feng147369/high-speed-intelligent-particle-pulse-discrimination-system/board/photos/platform.png

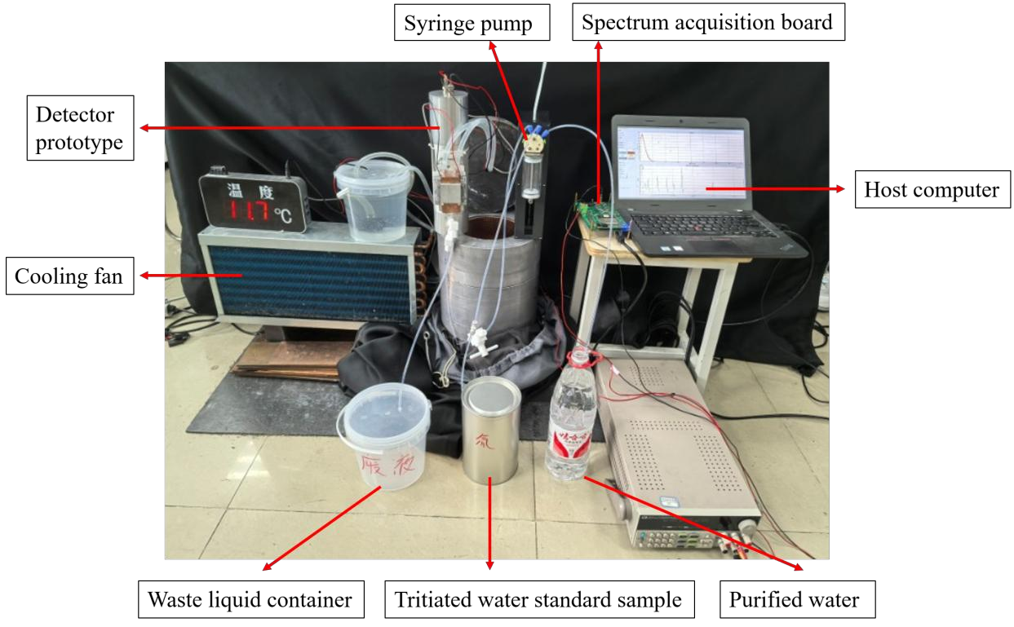
board/photos/platform.png
