feng147369/high-speed-intelligent-particle-pulse-discrimination-system/board/photos/enclosure.png

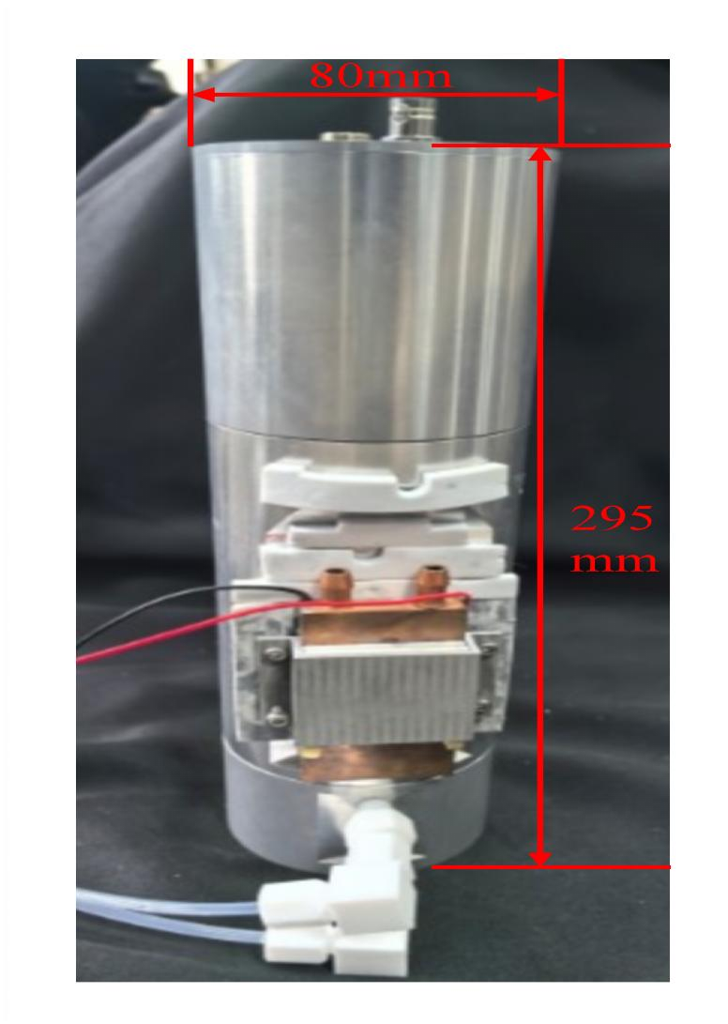
board/photos/enclosure.png
