feng147369/high-speed-intelligent-particle-pulse-discrimination-system/README.md

# 基于 FPGA 与轻量神经网络的高速氚水在线测量系统

全国大学生嵌入式芯片与系统设计竞赛 2026 · FPGA 自主选题赛道 · 高级组

## 项目简介

本项目面向核设施及环境水体中氚的在线监测需求，研制了一套集高速采集、实时波形处理、轻量神经网络甄别和网络测量分析于一体的氚水在线测量系统。

系统采用 CaF₂(Eu) 晶体探测器和光电倍增管完成信号探测与光电转换，使用 AD9694 四通道 14 位 500 MSPS ADC、LMK04828 时钟器件和 XC7K325T FPGA 构成高速数字化电子学。FPGA 通过 JESD204B 接收数据，以 250 MHz 双样点并行流水结构完成动态基线估计、触发、峰值、总积分、尾积分、脉宽和过阈样点统计。

系统部署定点轻量一维 CNN，通过统一事件号和事件缓存，将预筛、特征提取与 CNN 结果关联到同一事件。传统模式按预筛结果放行，AI 模式联合预筛、CNN 得分和原始波形满码检查形成最终判决。

有效事件进入原始波形上传和能谱累积路径，经 SiTCP 千兆以太网传输至 MATLAB 上位机，实现参数配置、波形与能谱显示、AI 状态回读、原始数据保存和氚水测量分析。系统已完成硬件设计、FPGA 开发、上位机集成、上板运行及氚水实测。

## 主要功能

- 500 MSPS 原始采样与 JESD204B 接收，每周期处理两个连续样点。
- 动态基线、候选触发、过阈样点预筛和波形特征提取。
- 1281 点原始事件缓存，首尾跨度 2.56 μs。
- 五点均值与降采样形成 257 点 CNN 输入。
- 定点 CNN 推理、Q14 得分判决和原始满码否决。
- 同一事件的预筛、特征、波形与 AI 判决关联。
- 波形及累计能谱完整包调度、48 位 FPGA 事件时间戳。
- 暂停排空、配置边界控制及网络背压处理。

## 硬件与工具

| 项目 | 配置 |
|---|---|
| FPGA | XC7K325T-2FFG900 |
| ADC | AD9694，四通道、14 位、500 MSPS |
| 时钟器件 | LMK04828 |
| 当前测量通道 | 板上通道 1，对应 AD9694 D 通道 |
| FPGA 样点处理 | 250 MHz，每周期两个连续样点 |
| 网络 | SiTCP、RGMII、千兆以太网 |
| 整机开发 | Vivado 2022.1 |
| AI 模块生成 | 2026.1 工具环境 |
| 上位机验证环境 | MATLAB R2025b |

## 测量成果

| 指标 | 结果 |
|---|---|
| 本底计数率 | 0.36 cps |
| 标准氚水样品计数率 | 160.24 cps |
| 净计数率 | 159.88 cps |
| 探测效率 | 约 0.04% |
| 最低可探测活度浓度 | 3255 Bq/L，4 h |
| 连续测量稳定性 | 12 h，计数率 RSD 0.96% |

## FPGA 实现结果

综合运行：`synth_raw_recording_20261103`；实现运行：`impl_raw_recording_20261103`。

| 项目 | 结果 |
|---|---|
| WNS / WHS | +0.069 ns / +0.052 ns |
| LUT / 寄存器 | 40074 / 55472 |
| Block RAM Tile / DSP | 265 / 318 |
| 总线偏斜约束 | 14 项通过，最小余量 +3.195 ns |
| 布线错误 / DRC Error | 0 / 0 |

## 仓库结构

```text
tritium_fpga/
├── README.md
├── src/       公开处理模块、IP 配置与约束
├── sim/       当前模型和上位机验证结果
├── build/     成功运行的文本报告与版本信息
├── board/     整机、板卡与实验平台实物
├── data/      波形、模型与测量参考结果
├── skill/     技能包目录
└── report/    设计报告、框图与协作记录
```

## 资料使用

1. 阅读[公开源码与接口](src/README.md)，查看数据处理、CNN、事件门控和能谱模块。
2. 阅读[验证记录](sim/README.md)与[实现报告](build/README.md)，对照功能及工程结果。
3. 按[运行说明](board/README.md)了解测量连接、参数和上位机操作。
4. 使用[数据与参考结果](data/README.md)查看波形、模型和测量统计。
5. 使用[技能包](skill/README.md)分析 ILA 数据、复用诊断及模型部署流程。
6. 阅读[设计报告](report/README.md)和[大模型协作记录](report/llm_collaboration.md)。

公开文件校验值见 `manifest.json`。
