feng147369/high-speed-intelligent-particle-pulse-discrimination-system/skill/fpga-adc-pulse-ai/references/03-case-evidence.md

# 案例事实链与官方定义

范围限于 AD9694 标识板卡的低位固定与能谱改善过程，不并入其他板卡资料。所有数字来自已保存的分析摘要，原始 CSV 未随包分发，**不能用摘要重建波形**。

## 一、事实链

| 记录 | 验证结果 | 证据限制 |
|---|---|---|
| demo_adc.csv，16384 行 | A 通道 sample0 不同码 138、码间隔 32、低 5 位全 0；B/D 恒为 8160 | 常量 B/D 不能用于判定位数 |
| 内部 Ramp 一次有效采集 | A 的 8192 样点中，8191 个相邻差均模 16384 加 1 | 仅覆盖 A 与该测试注入路径 |
| read2 / read3 回读 | AB/CD ID=DC、mode=00、N=0D、N′=2F；scratch 通过 | 静态结果不能证明实际 SPI 频率；相同哈希不证明重复采集 |
| 用户仅改 0x0200 的 00→08 | 报告低位恢复；ad6684.csv 中 A sample0/1 不同码 2788/2810，C 为 1884/1911，四字段间隔 1、低 5 位取遍全部 32 种组合 | 该文件无 SPI 回读；不能当作 ENOB=14；B/D 仍为 8191 |
| 约 20 分钟能谱反馈 | 主双峰明显改善，仍存小凸起 | 未取得同条件前后完整累计直方图 |
| 1.csv / 2.csv | 前者无新事件；后者一次有效事件：51812−34488=17324，当前映射为 2165 道 | 未捕获 2172 道的稀有事件 |

另有照片与 BOM 标 AD9694，与 ID=DC 矛盾——保留矛盾，不作裁定。

## 二、历史量化数据

- 历史 real_9694.csv：16384 行、交织 32768 样本；A 幅值 344–4693；33 个脉冲峰 4676–4693；低 5 位出现全部 32 种组合。按 500 MSPS 覆盖 65.536 μs，重复周期 2 μs，半高宽估计 0.338 μs。
- v10 与 demo 对照：LMK 128 条配置、JESD/PHY 参数、主要复位序列一致；另存 lane 01/0F、13 条未公开写入差异，但未分别证明为掉同步根因。
- 保留 v10 接口的配置版仿真：48 条 SPI 写入与 demo 匹配、复位等待 ≥ 5 ms、无重复初始化；这不是完整 JESD 上板通过。

## 三、官方定义对照

| 项目 | AD9694 Rev.C | AD6684 Rev.A |
|---|---|---|
| 0x0004 ID | DB，第 74 页 | DC，第 75 页 |
| 0x0200 低 4 位默认 | 00，第 79 页 | 07，第 80 页 |
| 0x0200 = 00 | 全带宽 | 全带宽 |
| 全带宽输出位宽 | 14 位后补 2 个零，第 33 页 | 9 位后补 7 个零，第 32 页（启用 tail bits 时例外） |
| 0x0200 = 08 | 未列为支持模式 | VDR，第 80 页 |
| 0x058F=0D / 0x0590=2F | N14 / N′16、Subclass 1，第 91 页 | 同义，第 94 页 |

来源页码为指定版本页脚页码，换版须重新核对。

**推导**：9 位加 7 个零的 16 位字取 [15:2]，即 9 位加 5 个零，与原现象吻合。N 字段写 14 不能恢复已在内部模式中被置零的信息。模式对照支持"AD6684 功能行为"这一解释，**不等于实物鉴定**。

AD6684 第 51、52、88 页规定 VDR 受频谱 mask 约束、可降位；0x0430 默认 01 为复数模式。独立实数脉冲须核对实数模式与调谐频带：0x0430=00、0x0434=02 是实数 0～fs/4 的**待验证方案**，不是强制全带宽 14 位。

## 四、未闭环项目

- 未提供冷上电默认模式与被动原始 ID 位序的实板验证结果。
- 未记录 VDR 降位状态，不能承诺全条件 14 位有效精度。
- B/D 恒值与第二块板的 JESD 不稳定未计入已解决项。
- 截图主峰 2161 道 17973 计数、总计数 78803、2172 道 2 计数；单道占约 0.00254%，**不是**次峰积分占比。纵轴只到 120，不能据图求 FWHM。
- 稀有凸起未被捕获，不直接归因于 VDR、堆积或基线。
