feng147369/high-speed-intelligent-particle-pulse-discrimination-system/data/README.md

# 测试数据与参考结果

## 目录

- waveforms/：四组完整波形 CSV、提取说明及统计。
- measurements/：氚水测量结果。
- model/：模型参数、规则标签、划分、预测及评估结果。
- figures/：原始波形图。

## 四组完整波形

四组波形采集于 **2026 年 9 月 7 日至 9 月 15 日**。日期记录见 `waveforms/acquisition_dates.json`。

每帧保留 257 个 16 位采样字，共 85925 帧。

| 数据组 | 文件 | 有效帧数 |
|---|---|---:|
| PMT 单独测量 | group_1_waveforms.csv | 16631 |
| 本底 | group_2_waveforms.csv | 5156 |
| 氚水样品 | group_3_waveforms.csv | 62387 |
| 25 ℃遮光本底 | group_6_waveforms.csv | 1751 |

原始提取结果位于 waveforms/，图形展示孤立小脉冲、离散脉冲、密集脉冲簇和高幅度事件。

## 当前模型数据

当前模型使用本底批次 13497 条、氚水批次 12258 条，共 25755 条原始波形。原始事件为 1281 点，2 ns/点，首尾跨度 2.56 μs；模型输入为五点均值和步长 5 处理后的 257 点。

标签按完整窗口中独立连续过阈区段建立：回落后再次过阈计为新区段；至少 4 个区段且原始帧未满码为候选；任一点达到 65532 或以上执行满码拒绝。采集批次分别按时间划分训练、验证和留出数据，集合间设置空档。

## 模型结果

时间留出集 3864 条，规则正类 1161 条、规则负类 2703 条。以下结果按上述波形规则标签计算。

| 判决 | 正类召回率 | 负类误放率 | 通过中符合规则比例 |
|---|---:|---:|---:|
| 原定点模型 | 18.43% | 20.75% | 27.61% |
| 新定点 CNN | 84.15% | 3.33% | 91.57% |
| 新 CNN 与原始满码否决联合 | 84.15% | 0.37% | 98.99% |

模型标识为 20261103，默认 Q14 阈值为 4043。model/ 保存浮点和定点参数、标签划分、量化验证及预测结果。

## 氚水测量

标准样品比活度为 2.230×10⁴ Bq/g，测量体积为 18 mL，PMT 高压为 900 V。

| 参数 | 结果 |
|---|---|
| 本底计数率 | 0.36 cps |
| 样品计数率 | 160.24 cps |
| 净计数率 | 159.88 cps |
| 探测效率 | 约 0.04% |
| 最低可探测活度浓度 | 3255 Bq/L，4 h |
| 连续测量稳定性 | 12 h，RSD 0.96% |

净计数率 `Rn=Rs-Rb`；探测效率 `ε=Rn/(aρV)`。结果表位于 measurements/results.csv。

## 单位

原始样点为 uint16，间隔 2 ns；CNN 输入间隔 10 ns；得分为有符号 Q14；FPGA 时间戳为 48 位、4 ns/刻度；能谱每道计数为 uint32；计数率单位 cps，活度浓度单位 Bq/L。
