feng147369/high-speed-intelligent-particle-pulse-discrimination-system/skill/pitfalls.md

# 高速采集与脉冲 AI 开发经验

## 1. 将“位数异常”转为原始码统计

现象：采样字低位固定，码值呈固定间隔变化。

处理：检查解包后的原始字段，统计低位集合、码值间隔和有效周期，再核对器件模式与接收端切片。

提炼：将转换数据、内部处理格式、传输字和算法输入逐层对应，定位信息在哪一层发生变化。

## 2. 先检查 SPI 读阶段的方向控制

现象：寄存器读回全零或全 FF，重复读取仍保持相同值。

处理：检查 SDIO 在读阶段的释放、顶层 IOBUF 使能、指令位序和采样时刻，并通过暂存器校验和原始串行观察复核。

提炼：回读结果与总线行为一起记录，再使用寄存器值分析器件。

## 3. 区分锁存结果和独立事件

现象：ILA 中相同峰值连续保持多行。

处理：用事件有效信号筛选峰值，并分别统计采样行数、有效周期和事件次数。

提炼：字段更新机制决定统计口径。锁存字段按更新事件统计。

## 4. 从活动工程对照示例与业务差异

现象：同一板卡在示例工程正常，在业务工程出现同步异常。

处理：从实际顶层和活动文件出发，对照时钟、ADC、JESD204B、复位及运行期配置，逐项复验。

提炼：源码注释、历史副本和当前加载配置分别核对，以实际工程数据流作为定位入口。

## 5. 原始点数需要对应物理时间

现象：模型输入同为 257 点，但采样间隔改变后覆盖时间不同。

处理：固定 2.56 μs 观察窗，使用 1281 点原始帧，经五点均值和步长 5 形成 257 点输入。

提炼：窗口长度、点间隔和预处理一起管理，训练与硬件使用相同输入定义。

## 6. 将人工“峰数”判据落实为可执行规则

现象：回摆、小峰和连续过阈区段的不同计法会改变标签。

处理：按已确认的规则，回落后再次过阈计为新区段；完整窗口内至少 4 个区段且未满码为候选。

提炼：将会改变标签的边界用具体波形确认，并保存规则版本。

## 7. 采集来源与事件标签分别保存

现象：同一个样品批次内包含多种波形形态。

处理：来源作为采集元数据，逐事件按统一规则标注。本底与氚水数据使用相同标签定义。

提炼：保留原始来源、采集参数和逐事件标签之间的对应关系。

## 8. 原始满码检查放在均值处理之前

现象：短暂单点满码经过五点均值后幅度降低。

处理：扫描完整 1281 点原始帧，独立保存满码标志，再与 CNN 得分联合判决。

提炼：需要保留的原始域条件在信息变换前计算，模型得分和组合判决原因分别记录。

## 9. 为定点运算建立独立整数参考

现象：浮点结果相符，但定点截断、负数舍入或端点处理出现差异。

处理：明确数值格式和运算顺序，建立独立整数实现，再比较 HLS C 和 RTL 的逐事件得分。

提炼：按输入、预处理、中间层和输出逐级查找首个差异。

## 10. 同一事件使用共同触发和事件号

现象：模块独立测试正常，实际顶层未形成预期输出。

处理：检查共同事件触发、外部事件模式、事件号、有效信号及结果完成条件，并通过真实顶层验证完整包和能谱写入。

提炼：模块接口与顶层连接一起验收。

## 11. 将模型 RTL 与 ROM 作为同一组资产

现象：更新 RTL 后，综合运行目录中的 ROM 文件仍对应旧模型。

处理：综合前复制权重文件，核对实际文件校验值、模型标识和默认阈值。

提炼：模型版本同时关联 RTL、ROM、预处理和阈值。

## 12. 模式设置先于上传点数

现象：上位机配置为 1281 点，实际包仍为 256 点。

处理：先切换模式并完成初始化，再设置处理参数，最后设置上传点数；从实际数据包核对点数。

提炼：按复位依赖组织配置顺序。

## 13. 暂停新事务，同时完成在途事务

现象：暂停后，已有事件仍等待计算或网络发送，配置更新被阻塞。

处理：分开控制新事件接收、在途计算和完整包发送，待边界到达后应用配置。

提炼：暂停、排空、配置和恢复分别定义状态转换。

## 14. 将显示切换与采集控制分开

现象：通过输出模式命令切换页面，引起内部复位。

处理：持续传输波形与累计能谱，上位机按钮仅切换显示页。

提炼：采集、传输、保存和绘图分别管理。

## 15. 在事件发生处记录时间

现象：网络积压和绘图刷新影响主机接收间隔。

处理：在 FPGA 触发时锁存时间戳，随事件上传，分别保存采集时间和主机记录时间。

提炼：使用事件时间计算间隔，将队列和界面耗时单独观察。

## 16. 采集日期与处理日期分别归档

四组完整波形采集于 2026 年 9 月 7 日至 9 月 15 日。

采集日期记录实验发生时间；数据提取、模型训练、仿真和发布使用各自的处理日期。文件生成时间和导出时间作为独立元数据保存。
