feng147369/high-speed-intelligent-particle-pulse-discrimination-system/skill/workflow.md

# 高速采集与脉冲 AI 协作工作流

## 工作流组成

整个流程分为采集链检查和模型部署两部分。

采集链检查建立原始数据、工作模式和工程配置之间的对应关系；模型部署在此基础上完成标签、训练、定点计算和事件级接入。

## 一、采集链检查

### 1. 建立工程与数据对应关系

记录板卡、器件、实际顶层、活动源码、IP、时钟、通道映射及采集条件。

将原始 CSV 与对应工程版本关联，明确每个字段的位宽、进制、有效条件及采样顺序。

### 2. 量化原始码

先检查原始样点的：

- 低位取值集合。
- 相邻码值间隔。
- 有效数据比例。
- 双样点顺序。
- 固定值与变化值分布。
- 有效事件对应的峰值及统计。

对于锁存的峰值字段，通过事件有效信号统计事件次数。

### 3. 检查 SPI 回读

核对片选、指令、地址、位序、采样时刻和读阶段 SDIO 方向。

使用回读校验、重复读取和原始串行观察建立读回结果与总线行为的对应关系。

### 4. 核对模式与输出格式

对照实际型号和修订版，核对工作模式、传输位宽、输出格式及接收端切片。

将器件标识、回读模式和采样码行为共同纳入判断。

### 5. 对照实际工程

比较示例工程和业务工程的：

- ADC 配置表及写入顺序。
- LMK 时钟配置。
- SPI 分频与配置等待时间。
- 复位及 SYSREF 控制。
- JESD204B 与 PHY 参数。
- 运行期寄存器。
- 引脚与时序约束。

### 6. 单变量修改与复验

每轮记录基线、唯一改动、预期现象、实际结果和回退方式。

修改后同时检查原始码、有效数据、同步状态和能谱表现，并保存对应结果。

## 二、脉冲 CNN 部署

### 1. 固定输入的物理时间

先定义采样间隔和观察窗，再确定输入点数。

本项目以 1281 个 2 ns 原始点覆盖 2.56 μs，经五点均值、步长 5 和端点延拓形成 257 点、10 ns 间隔的 CNN 输入。

### 2. 定义逐事件标签

将人工判据转成可执行规则，明确：

- 基线计算。
- 过阈比较条件。
- 独立过阈区段的计数方式。
- 回落后再次过阈的处理。
- 原始满码条件。

采集来源、样品信息和逐事件标签分别保存。

### 3. 组织训练与评估

按采集时间划分训练、验证和留出数据，在相邻集合间设置空档。

用训练集更新权重，用验证集选择轮次和阈值，使用留出集统计最终工作点的结果。

同时保存召回、误放及各类波形的分组结果。

### 4. 固定数值实现

明确均值、端点、基线、缩放、舍入、截断和溢出行为。

将模型参数导出为定点格式，建立独立整数参考，保存逐事件得分。

### 5. 逐级核对

按照以下顺序使用相同输入比较：

1. 训练框架与独立浮点实现。
2. 浮点与定点软件实现。
3. 独立整数参考。
4. HLS C。
5. RTL。

发现差异时，按输入、预处理、中间层和输出定位首个不一致位置。

### 6. 接入事件处理链

以同一触发建立事件号，锁存输入、基线和阈值。

预筛、特征和 CNN 并行处理，最终门控等待对应事件的结果。通过后执行波形上传与能谱累积，拒绝后释放事件缓存。

原始满码标志在均值和降采样之前计算，并随事件参与最终判决。

### 7. 完成实现与运行记录

关联保存源码、模型、ROM、配置、验证结果、实现报告和板上测量记录。

## 三、可复用提示词

以下模板用于新任务，按实际工程填写方括号内容。

### 原始码分析

请分析[工程与通道]的原始 ADC 数据。输入格式为[位宽、进制、移位方式]，有效条件为[信号或字段]。请统计低位集合、码值间隔、样点顺序及有效事件，指出异常最早出现的位置，并列出下一项可区分原因的实验。

### 工程对照

请从实际顶层出发，对照[示例工程]和[业务工程]的活动源码、ADC 配置、时钟、复位、JESD204B 参数、运行期寄存器和约束。每项差异列出代码位置、影响路径及单变量复验方法。

### 标签与时间窗

请先核对[原始点数、采样间隔、窗口位置]，再将[人工波形判据]转成逐事件规则。对过阈、回落、窗口首末点及满码条件给出具体例子，并保持数据、标签和配置可回查。

### 定点一致性

请使用同一批输入核对软件整数参考、HLS C 和 RTL。固定[预处理、权重、位宽、舍入、阈值]，逐事件比较得分；出现差异时定位首个不一致的处理阶段，并给出修正后的全批次结果。

### 事件级接入

请以完整事件为单位接入模型，明确输入、事件号、阈值、结果与缓存的生命周期。测试覆盖预筛通过与拒绝、模型通过与拒绝、满码、忙时新事件、TCP 背压、暂停和复位。

## 四、归档内容

每项任务保存：

- 原始需求与输入材料。
- 提示词和模型回答。
- 采用的方案及代码变更。
- 测试输入和参考结果。
- 仿真与实现输出。
- 纠正过程。
- 板上反馈与测量记录。
