feng147369/high-speed-intelligent-particle-pulse-discrimination-system/skill/fpga-adc-pulse-ai/references/05-ai-case-parameters.md

# AI 案例参数与验证证据

以下为本案例的具体参数。它们可复现，但**不是**跨任务的默认值——换采样率、增益、触发阈值或样品条件后必须重新确定。

## 一、输入与标签

- 数据：两批新实测波形共 25755 条，其中本底 13497 条、氚水测量 12258 条。
- 原始输入：1281 个无符号 16 位码值，采样间隔 2 ns，首末点跨度 2.56 μs。
- 离线规则基线：取原始帧前 100 点中位数；两批阈值分别为 4000、3500 码。
- 候选判定：逐点比较 `sample >= baseline + threshold`，独立连续过阈区段数 ≥ 4 且无上满码；回落后再次过阈计新段。任一原始值 ≥ 65532 时拒绝。
- 不额外引入最小脉宽、间隔或突出度。

两处必须说明的边界：该基线是**用于自动标注的离线估计**，不等于未记录的实时动态基线；两批采集阈值不同，不能只用候选数量比较物理甄别性能。模型没有触发阈值输入，改阈值后需重新评估。

## 二、预处理的精确定义

对原始帧 `r[0..1280]`，模型输入 `m[0..256]`：

```text
c = 5*j
m[j] = floor(sum(r[clamp(c+k, 0, 1280)] for k in [-2,-1,0,1,2]) / 5)
q[j] = floor((16*m[j] - sum(m[0:16])) / 32)
```

`q` 为 Q14 整数输入。负数按向负无穷取整，与所用算术移位一致。物理窗口 2.56 μs，AI 采样中心间隔 10 ns。端点通过复制边界样本处理，不删除最后一点，不做逐波形单位幅度归一化。

原始冲顶判断先于均值处理，覆盖完整 1281 点，并排除存储末对中不属于有效帧的附加数据。

## 三、网络与数值格式

```text
257×1
 → Conv8(k5, same) → BN → ReLU → MaxPool2(ceil, 129点)
 → Conv8(k9, same) → BN → ReLU → MaxPool2(ceil, 65点)
 → Conv8(k15, same) → BN → ReLU
 → 全局平均池化 → Dense8/ReLU → 单logit
```

- 训练参数 1729 个；BN 折叠后推理参数 1681 个。
- 权重 12 位、8 位小数；激活 24 位、14 位小数；累加器 56 位。
- 判决阈值 Q14 整数 4043，即 logit 0.24676513671875，严格大于比较。该值是 **logit 工作点**，不是概率 24.68%。
- 最终 AI 判决：`score_Q14 > 4043 && !raw_saturated`，再与既有候选许可组合才进入门控后续链路。

## 四、训练与评估

使用既有结构及预训练初始化，二分类标签来自新实测波形的用户规则。固定种子 20261103。两批分别按时间前 60% 训练、65%–80% 验证、后 15% 留出，中间各 5% 空档。训练 15452 条、验证 3863 条、留出 3864 条，另 2576 条作为空档。训练对候选、未饱和少峰负例和饱和负例均衡采样；验证集选定第 28 轮及阈值。

留出集含规则正例 1161 条、规则负例 2703 条。

| 判决版本 | TP | FN | FP | TN | 规则正例召回 | 规则负例误放 | 通过中符合规则比例 |
|---|---:|---:|---:|---:|---:|---:|---:|
| 新定点 CNN | 977 | 184 | 90 | 2613 | 84.15% | 3.33% | 91.57% |
| 新定点 CNN + 原始冲顶否决 | 977 | 184 | 10 | 2693 | 84.15% | 0.37% | 98.99% |

分组边界：2637 条饱和负例中，CNN 单独误放 80 条，加原始否决后为 0；66 条未饱和 0–3 峰负例中仍误放 10 条（15.15%）。以上均为**相对自动规则标签**的结果，不是物理探测效率。

## 五、已有工程证据

| 层次 | 现有证据 | 可以支持的结论 |
|---|---|---|
| 通用 demo | 128 组输入 / 640 输出，RTL 与 C 逐项一致 | 模型转换与推理工具链跑通 |
| 浮点前向 | 128 组，两种实现最大绝对误差 4.48×10⁻⁶ | 结构、排列与 BN 折叠实现相符 |
| 定点软件 | 独立整数探针精确一致；留出判决与浮点一致 99.77% | 当前格式的数值行为已对照 |
| 新权重 HLS/RTL | 128 组真实验证/留出波形整数得分精确匹配 | 当前 AI 推理核数值链通过 |
| 完整 AI 支路 | 24 帧，含单点冲顶、边界位置、真实留出波形 | 当前硬否决与模型组合功能通过 |
| 事件级接入 | AI 拒绝事件未进入受门控输出与统计 | 当前事件关联与放行链经过仿真 |
| 目标工程 | 综合、实现及既有时序检查通过 | 当前 AI 接入工程可完成实现 |
| 板上运行 | 本案例板上反馈：整链实测跑通 | 运行链路已闭环；不增加未测得的统计指标 |

工具版本组合：HLS 转换用 2026.1，生成的纯 RTL 与权重 ROM 由 2022.1 完成目标工程实现。这是本案例已验证的组合，**不是**对所有生成 IP 的兼容承诺。

原始冲顶 RTL 测试记录中存在测试主动复位时的已知 CDC 检查器提示，不写成"所有日志完全无提示"。

## 六、复现入口

以下是原工作区的路径，本包不包含原始数据、训练环境与完整工程，因此不是脱离工作区的一键训练归档。

- 通用 demo：`D:/fpga/one_channel/ai_demo/hls4ml_demo/run_demo.py`
- 数据整理、标签、训练、定点：`D:/fpga/one_channel/v14/training_tritium_20261103/` 下 `audit_inputs.py`、`prepare_labels.py`、`train_binary.py`、`verify_quantized.py`
- 当前定点权重：`D:/fpga/one_channel/v14/ai/quantized_model.npz`
- 新模型 HLS 导出：`D:/fpga/one_channel/v14/verification_binary_20261103/hls/`
- 完整 AI 支路与事件级验证：同目录 `verify_veto.py`、`verify_top_path.py`

历史结果文件中的"未部署/未执行 RTL"是软件训练阶段的状态，后续接入结果另行记录，不覆盖历史文件伪装成同一阶段。
