feng147369/high-speed-intelligent-particle-pulse-discrimination-system/board/photos/board.png

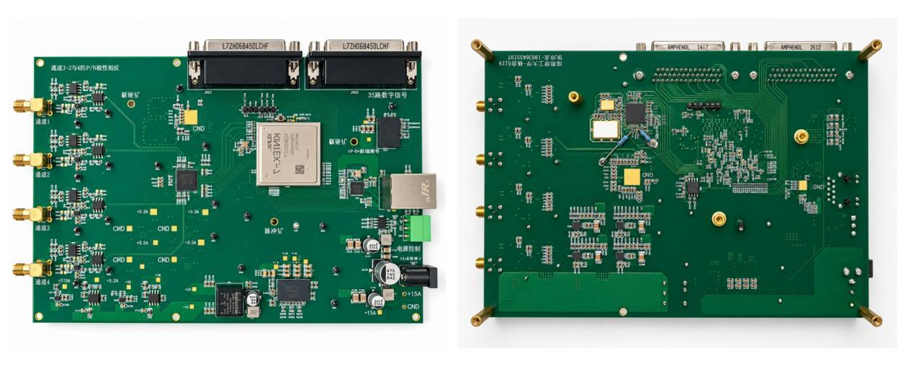
board/photos/board.png
