feng147369/high-speed-intelligent-particle-pulse-discrimination-system/board/photos/cooling.png

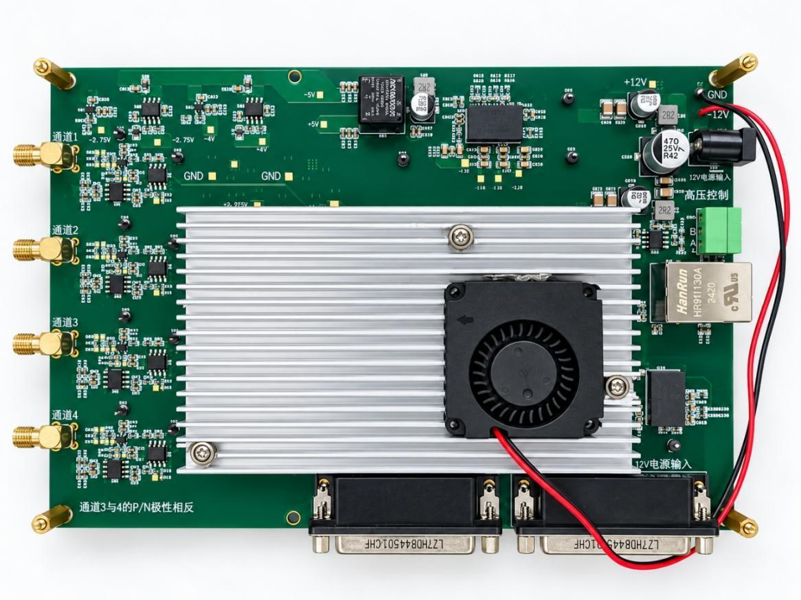
board/photos/cooling.png
