feng147369/high-speed-intelligent-particle-pulse-discrimination-system/data/figures/tritium_event_8.png

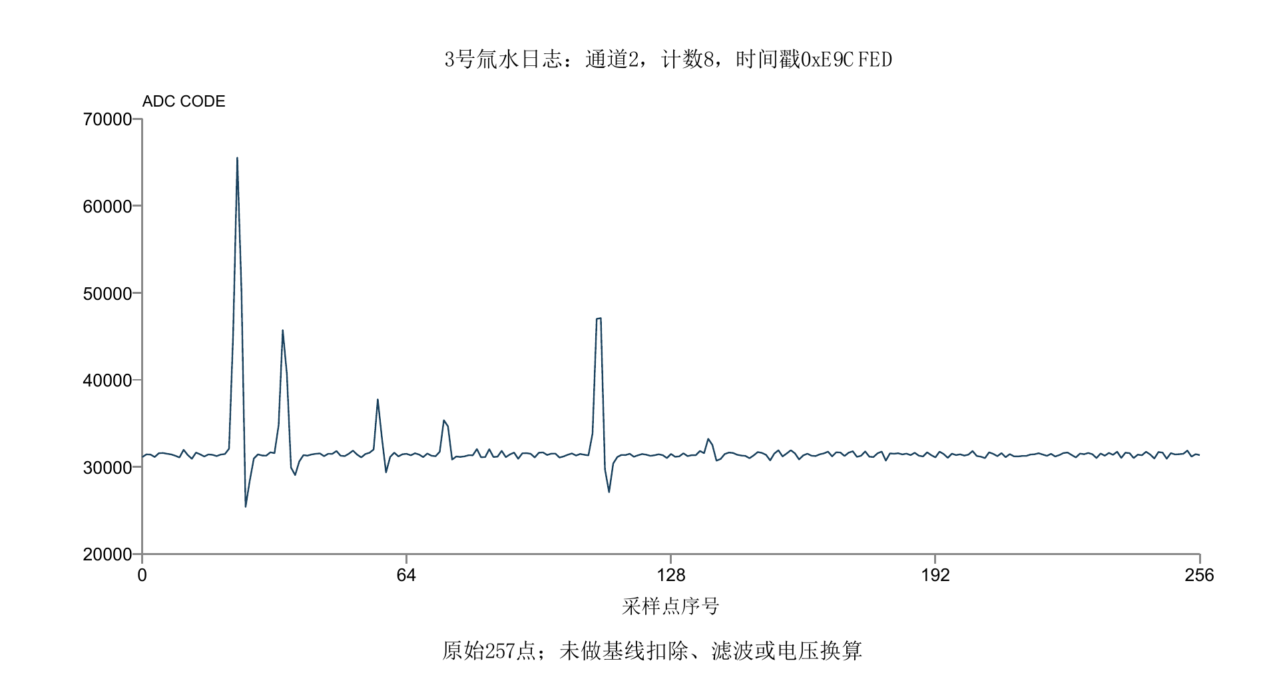
data/figures/tritium_event_8.png
