feng147369/high-speed-intelligent-particle-pulse-discrimination-system/data/figures/waveform_comparison.png

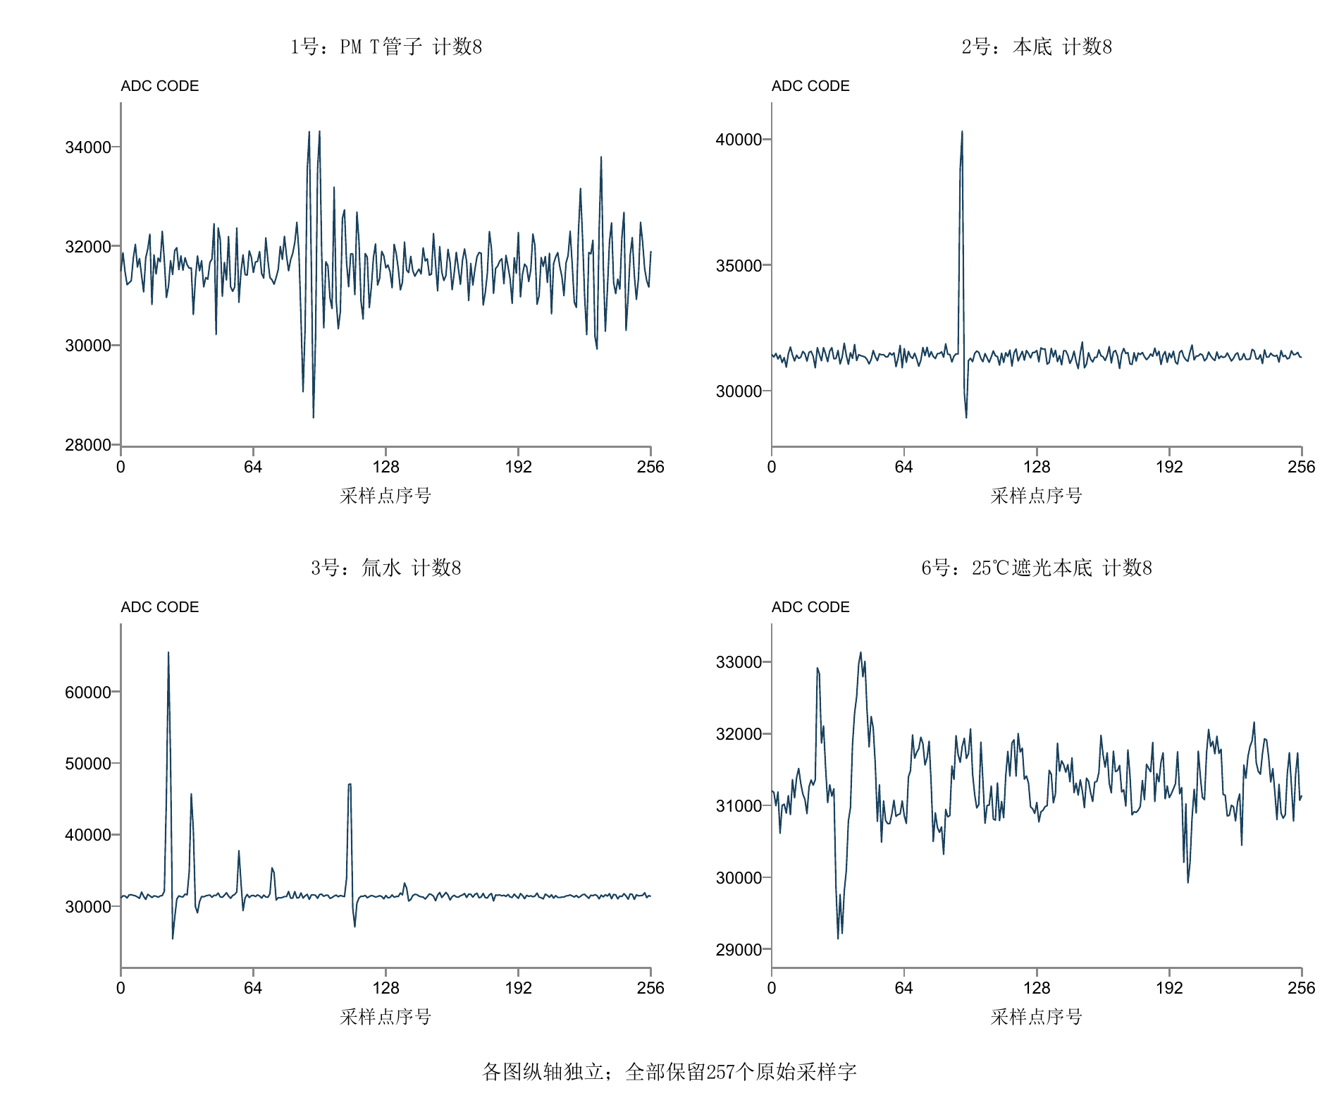
data/figures/waveform_comparison.png
