feng147369/high-speed-intelligent-particle-pulse-discrimination-system/data/model/real_waveform_examples.png

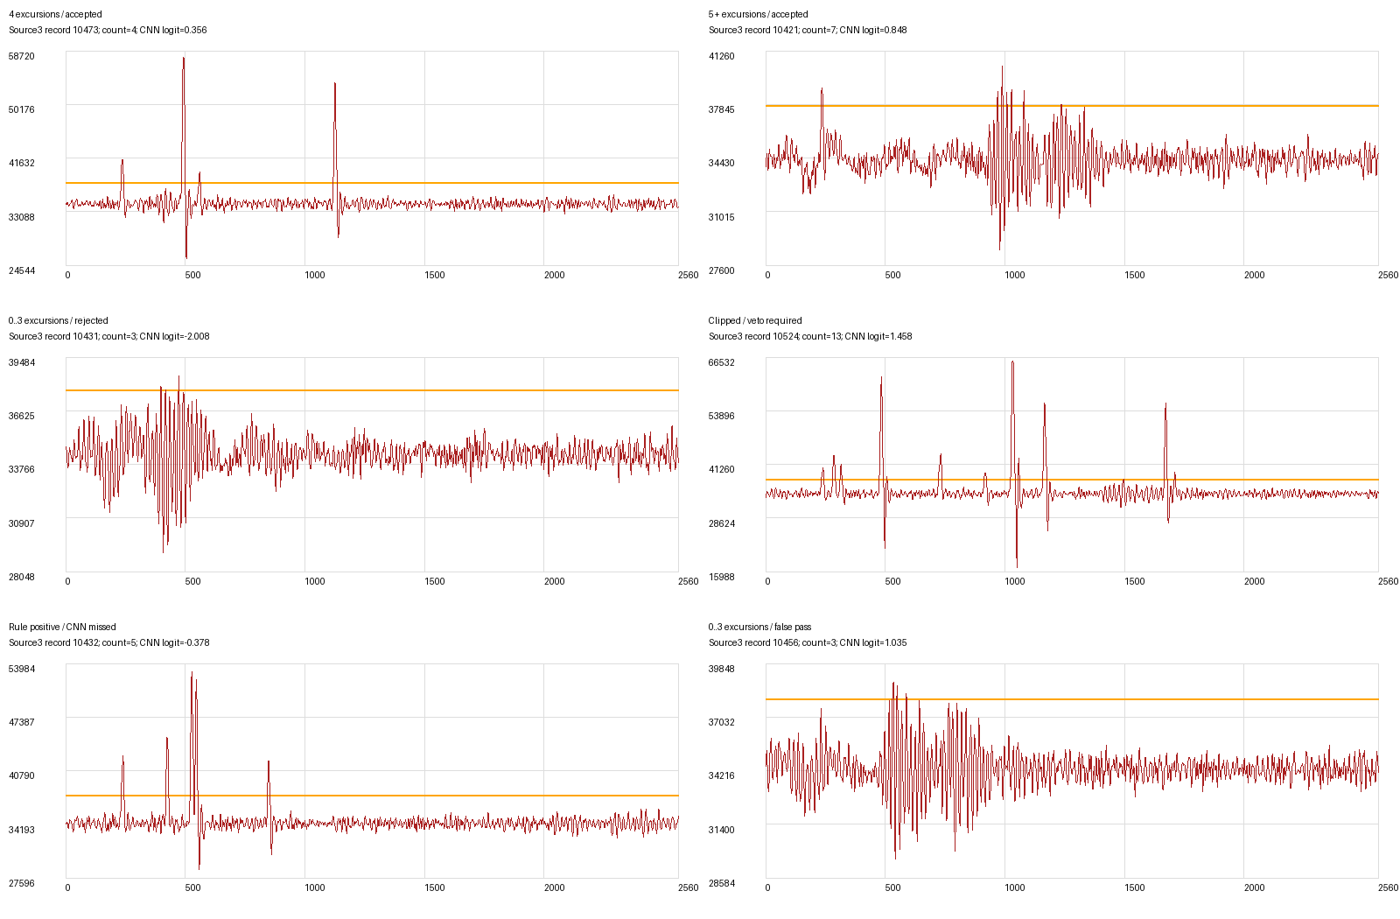
data/model/real_waveform_examples.png
