feng147369/high-speed-intelligent-particle-pulse-discrimination-system/data/model/review_intervals.png

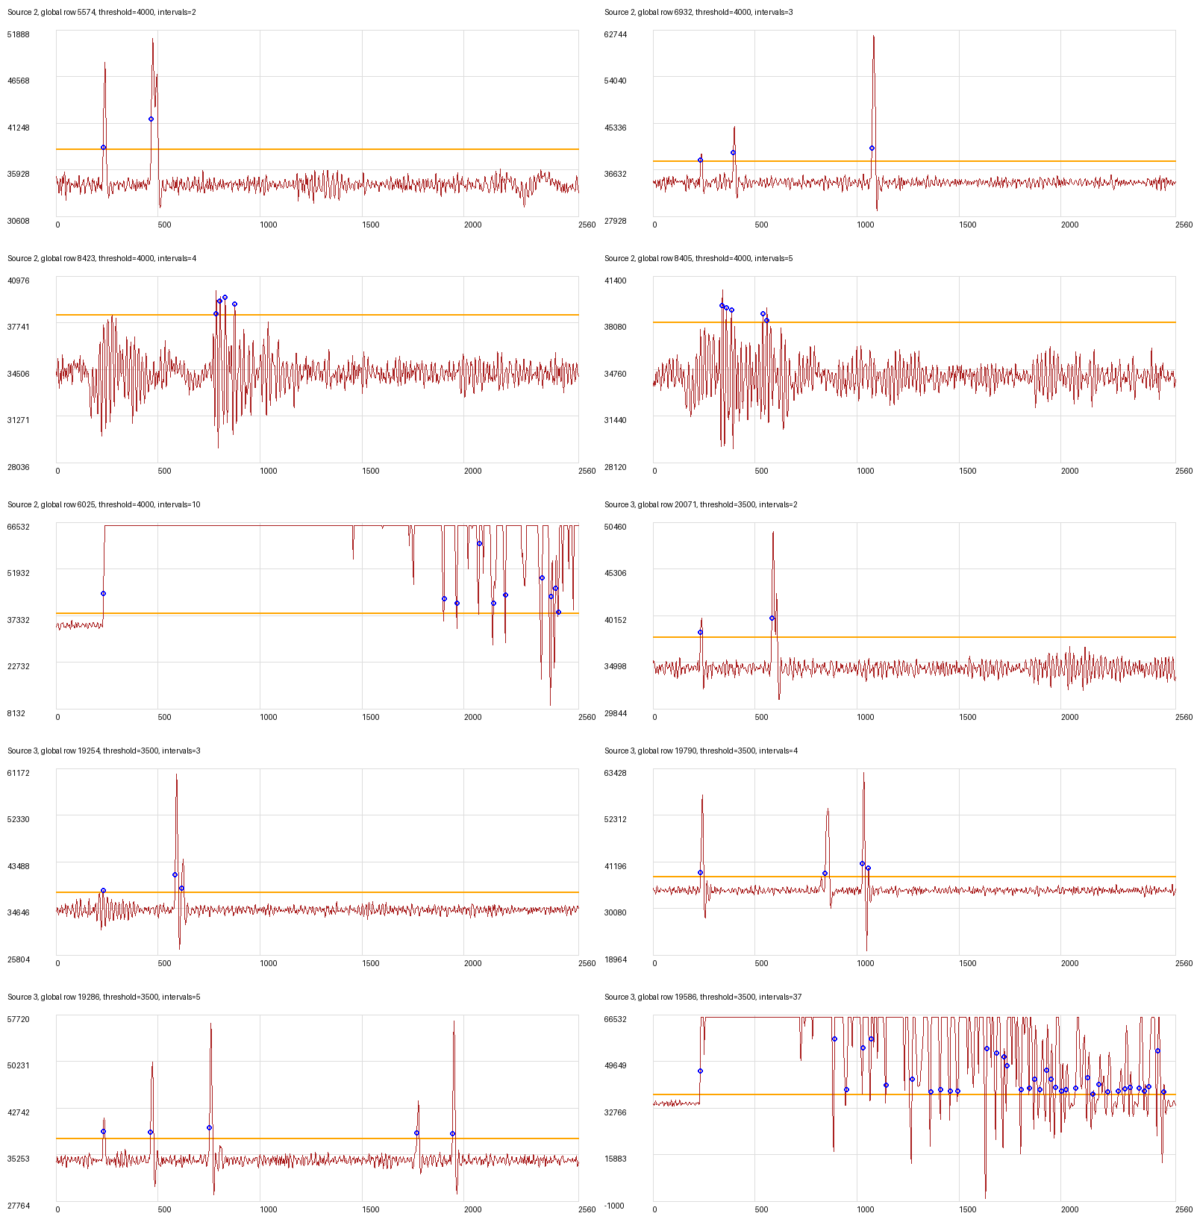
data/model/review_intervals.png
